felixsuhimitsu/cast-256/docs/10-devbook/DEVELOPMENT_BOOK.md

# DEVELOPMENT BOOK — Đã thử gì, sai ở đâu, vì sao chọn hướng này

**Artifact xuyên suốt** · Cập nhật: 2026-09-09

---

## 1. Tài liệu này khác ADR ở chỗ nào

- **ADR** ghi *quyết định*: chọn gì, vì sao, hệ quả. Bất biến sau khi Accepted.
- **Development Book** ghi *quá trình*: đã thử gì, cái gì không chạy, số đo thật, người
  sửa AI ở đâu. Ghi thêm liên tục, không xóa.

Một điều sai đã thử mà không được ghi lại sẽ bị thử lại. Đó là lý do phần §4 tồn tại.

---

## 2. Nhật ký theo work package

### WP-00 — Khung dự án · TT: ✅ Done (2026-09-09)

**Đã làm:**
- Xóa `rtl/` và `sim/` cũ (giữ nguyên trong lịch sử git trên nhánh `main`), dựng cây mới
  theo `MODULE_MAP.md` §1: `config/`, `ip/aes256/`, `ip/sha256/`, `protocol/`, `fabric/`, `io/`.
- `sim/lib/tb_util.vh`: macro `CHECK_EQ` / `CHECK_TRUE` / `CHECK_LE` / `TB_END` / `TB_TIMEOUT`.
  `TB_END` dùng `$fatal(1,...)` để iverilog trả **mã thoát khác 0** khi FAIL — điều kiện
  của REQ-V-01. Nếu chỉ `$finish` thì testbench FAIL vẫn trả 0 và CI sẽ báo xanh sai.
- `sim/lib/csi_checker.v`: module kiểm tự động INV-1..6 và quy tắc bắt tay H2, H5 của hợp
  đồng CSI. Instantiate song song với IP, đếm vi phạm ra cổng `viol_count`.
- `scripts/check_headers.sh` (REQ-N-02), `scripts/check_layering.sh` (MODULE_MAP §4).
- `Makefile`: target `lint / sim-* / synth-aes / synth-sha / synth / flash / test / bench`.

**Ba chỗ đưa bài học cũ thẳng vào công cụ, không để trong đầu:**
1. `synth` dùng `2>&1 | tee` cho nextpnr — công cụ ghi toàn bộ ra stderr, thiếu `2>&1`
   thì log luôn 0 byte (§4.1 mục 8).
2. `YOSYS_FLAGS` cố định `-nowidelut` kèm bình luận giải thích, để không ai bỏ đi lần nữa
   (§4.1 mục 3).
3. Target `test`/`bench` gọi `/usr/bin/python3` tường minh, không dùng `python3` (§4.1 mục 9).
   `PORT` mặc định `/dev/ttyUSB1`, có ghi chú `ttyUSB0` là JTAG (§4.1 mục 5).

**Tự kiểm gate (quan trọng):** `make lint` chạy sạch trên cây rỗng — nhưng "sạch" khi
không có gì để kiểm là vô nghĩa, đúng kiểu Done giả số 1 trong `DEFINITION_OF_DONE.md` §4.
Vì vậy đã dựng vi phạm cố ý để kiểm chính cái gate:

| Vi phạm dựng lên | Gate | Kết quả |
|---|---|---|
| File trong `ip/aes256/` không có header | `check_headers.sh` | FAIL, exit=1 ✅ |
| Module trong `ip/` instantiate module của `io/` | `check_layering.sh` | FAIL, exit=1 ✅ |
| (sau khi dọn) | cả hai | PASS, exit=0 ✅ |

Gate được chứng minh là bắt được vi phạm thật, không phải luôn xanh.

**Còn nợ (đã xử lý một phần ở WP-01):** `constraints/tangnano9k.cst` kế thừa có hai vấn
đề — 3 LED khai `LVCMOS18` trong khi `rst_n` cùng IO bank là `LVCMOS33` (làm `gowin_pack`
dừng, không sinh bitstream), và gán chân UART bị ngược. `constraints/uart_echo.cst` của
WP-01 đã dùng gán chân đúng và LVCMOS33 toàn bộ, đã kiểm chứng trên board. File
`tangnano9k.cst` sẽ được viết lại ở WP-07 dựa trên bản đã kiểm chứng này.

### WP-01 — Đường ống UART trần · TT: ✅ Done (2026-09-09) — **GATE CỨNG ĐÃ QUA**

**Đã làm:** `baud_gen.v`, `uart_rx.v`, `uart_tx.v` + bitstream thăm dò
`rtl/probe/uart_echo_top.v` (FIFO 16 byte). Tổng hợp 331 LUT4, F_max 140 MHz.

#### Lỗi 1 — testbench bắt được lỗi thật trong `uart_rx`

TC-301 (biểu quyết 3 điểm chống nhiễu) FAIL 6/8: nhiễu 1 chu kỳ trên các bit có
giá trị 0 vẫn lọt qua ở bit 3 và bit 5.

Nguyên nhân: `vote` được dùng ở **đúng chu kỳ** mà `samples[2]` đang được gán.
Vì gán là nonblocking, `vote` đọc giá trị **cũ** của `samples[2]` — vốn là `1`
từ lần reset. Nên với bit giá trị 0, phép biểu quyết thành `majority(s0, s1, 1)`:
chỉ cần một trong hai mẫu còn lại bị nhiễu là kết quả lật.

Sửa: thêm `SDEC = S2 + 1`, quyết định trễ một chu kỳ sau mẫu cuối. Dự phòng bắt
sườn start còn 234 − 126 = **108 chu kỳ**, vẫn dư xa so với 3.75 chu kỳ của
thiết kế cũ. TC-300..302 sau đó PASS 10/10.

Đây đúng loại lỗi mà chỉ testbench có kịch bản nhiễu mới bắt được — một bộ test
chỉ gửi byte sạch sẽ PASS hoàn toàn.

#### Lỗi 2 — GÁN CHÂN UART CỦA THIẾT KẾ TRƯỚC BỊ NGƯỢC

Nạp lần đầu với `rx=17, tx=18` (chép từ `constraints/tangnano9k.cst` của thiết
kế cũ): **0/512 byte vọng về**, và ca đối chứng có nghỉ 1 ms cũng 0/64.

Chính ca đối chứng là thứ chỉ đúng hướng: nếu là mất đồng bộ tích lũy thì ca có
nghỉ phải chạy được. Cả hai đều bằng 0 nghĩa là **không có đường về**, tức là
vấn đề vật lý chứ không phải logic.

Đảo chân rồi nạp lại:

| Gán chân | 512 byte liên tục | 1024 | 4096 |
|---|---|---|---|
| rx=17, tx=18 (như thiết kế cũ) | **0/512** | — | — |
| **rx=18, tx=17** | **512/512** | **1024/1024** | **4096/4096** |

Kết luận: trên Tang Nano 9K, **chân 18 là FPGA THU, chân 17 là FPGA PHÁT**.
`constraints/tangnano9k.cst` kế thừa từ thiết kế trước ghi ngược, và điều này
phải sửa trước khi dùng ở WP-07.

> Ghi chú về nhận định trước đó: trong phiên làm việc trước, giả thuyết "đảo chân
> UART" từng bị coi là đã bác bỏ. Số đo ở đây cho thấy kết luận đó sai. Bằng
> chứng là 4096/4096 với gán chân đảo so với 0/512 với gán chân cũ, trên cùng
> một board, cùng một bitstream logic.

#### Kết quả gate

| Bài | Kết quả |
|---|---|
| TC-600a: 512 byte liên tục, không nghỉ | **0 byte mất** ✅ |
| TC-600b: nội dung đúng từng byte | ✅ |
| Bổ sung: 1024 byte | 0 mất ✅ |
| Bổ sung: 4096 byte | 0 mất ✅ |
| Thông lượng đo được | 4096 B trong 355.6 ms ≈ 11.5 kB/s (đạt trần lý thuyết) |

REQ-I-05 **đạt**, chứng minh trên phần cứng thật (REQ-V-03). Log gốc:
`evidence/hw/20260909-2230-TC600-uartloop-4096.log`.

### WP-02 — Thăm dò diện tích · TT: ✅ Done (2026-09-09)

**Đổi cách làm so với WBS.** Kế hoạch ban đầu là đo "khung rỗng" của AES và SHA. Nhưng
yosys sẽ tối ưu mất logic rỗng, cho ra số vô nghĩa — đo xong vẫn không biết gì. Thay vào
đó đã viết và đo **hai khối thật sự tốn diện tích nhất**: S-Box composite field và hàm nén
SHA-256. Số đo vì thế là số thật, và code viết ra dùng luôn được cho WP-03/WP-04.

**S-Box: sinh hằng số bằng Python trước, viết Verilog sau.**
`scripts/gen_sbox_basis.py` tìm phép đẳng cấu GF(2^8)→GF(((2²)²)²) bằng cách quét
(PHI, LAM, nghiệm t), rồi **kiểm đủ 256/256 giá trị so với S-Box FIPS 197 ngay trong
Python**. Chỉ khi Python báo PASS mới chép hằng số sang Verilog. Kết quả:
`PHI=2, LAM=8, t=0x41`. Đây là biện pháp trực tiếp cho RSK-03 — nếu để Verilog tự "đúng
hay sai thì chạy testbench mới biết" thì lỗi lộ ra dưới dạng "vector AES fail" không manh mối.

**Tự kiểm TC-100 bằng lỗi cố ý.** Đổi một hằng số ma trận từ `8'h6C` thành `8'h6D`:

| Phép kiểm | Với S-Box hỏng |
|---|---|
| Đối chiếu 256 giá trị | **FAIL** — 128 giá trị sai, exit=1 ✅ |
| Kiểm song ánh | **vẫn PASS** ⚠️ |

Đúng như RSK-03 dự đoán: S-Box sai vẫn có thể là song ánh. Nếu chỉ kiểm song ánh hoặc chỉ
thử vài giá trị thì lỗi lọt qua. Đây là lý do REQ-F-04 ghi rõ "đối chiếu **toàn bộ** 256".

**Một tối ưu có đo, và nó thực sự có tác dụng.** `sha256_compress` đo lần đầu 1132 LUT4,
trong đó 844 là LUT3 — mux 3 chiều trên 256 bit trạng thái `a..h` (ba nhánh
`init`/`step`/`finalize`). Bỏ việc nạp lại `a..h` ở nhánh `finalize` (khối kế tiếp dùng
`init` với `h_in = h_out`) → còn 2 nguồn → **892 LUT4, giảm 240 (21%)**.

Khác biệt so với ba lần "tối ưu" thất bại ở §4.1: lần này **đo trước, thấy chỗ tốn, rồi
mới sửa** — không phải đoán rồi sửa.

**Kết luận gate:** cả hai IP dự phóng vượt ngân sách *riêng* ban đầu, nhưng tổng toàn
thiết kế chỉ ~5740/8640 (66%), còn xa trần REQ-R-01. Theo đúng thủ tục gate: dừng lại, mở
[`ADR-0007`](../09-decisions/ADR-0007-dieu-chinh-ngan-sach-dien-tich.md), nới REQ-R-03
(2200→2400) và REQ-R-04 (1800→2000), giữ nguyên ngân sách tổng. Kèm hai quyết định kiến
trúc: AES dùng 16 S-Box (không phải 20, khóa vòng tính sẵn), `sha256_k` giữ dạng logic.

### WP-03 — IP SHA-256 · TT: ✅ Done (2026-09-09)

**Đã làm:** `sha256_pad.v` (đệm FIPS 180-4) + `sha256_ip.v` (đỉnh IP theo hợp đồng CSI),
ghép với `sha256_k/sched/compress` đã viết ở WP-02. Testbench `tb_sha256_ip.v` **PASS 17/17**.
Diện tích **1661 LUT4 / 1146 DFF / 464 ALU** — dưới ngưỡng REQ-R-04 (2000), dùng 83% ngân sách.

#### Lỗi 1 — điều khiển có thanh ghi làm lệch pha K[t] với W[t]

Bản đầu dùng tín hiệu điều khiển được ghi vào thanh ghi (`cmp_step <= 1'b1`). Hệ quả:
`round` tăng ở chu kỳ trước khi vòng nén tương ứng thực sự chạy, nên `K[1]` bị ghép với
`W[0]`. Đã phát hiện khi phân tích dạng sóng bằng tay trước cả khi chạy testbench.

Sửa: chuyển toàn bộ tín hiệu điều khiển sang **tổ hợp** dẫn xuất trực tiếp từ `state`.
Khi đó trong mỗi chu kỳ `ST_COMPRESS`, các đại lượng `round`, `w_t`, `k_t` và `step` đều
thuộc cùng một vòng. Thêm một trạng thái `ST_CINIT` một chu kỳ để nạp trạng thái H.

#### Lỗi 2 — tớ tự bịa vector kiểm chứng

Bản testbench đầu tiên có sáu giá trị digest cho các độ dài 55/56/63/64/119 byte được
viết ra từ trí nhớ, không tra nguồn. Khi đối chiếu lại bằng `hashlib`:

| Độ dài | Giá trị đã viết | Đúng? |
|---|---|---|
| 55 byte | `9f4390f8…0f734318` | đúng |
| **56 byte** | `…ef797686_86b6b6f3` | **SAI** (đúng là `…ef797068_6ec6738a`) |
| 63, 64 byte | — | đúng |
| **119 byte** | `1c8bfa4a…5d4f0b56` | **SAI hoàn toàn** |

Nếu để nguyên, hai vector sai này sẽ làm testbench FAIL trên một IP **đúng**, và nhiều
khả năng phản ứng tiếp theo là đi sửa RTL cho khớp vector sai. Đây chính là điều REQ-V-02
cấm: **không dùng vector tự sinh làm nguồn sự thật**.

Đã thay toàn bộ bằng giá trị sinh từ `hashlib` (hiện thực tham chiếu của FIPS 180-4) và
ghi rõ nguồn trong testbench.

#### Lỗi 3 — vi phạm hợp đồng CSI ở nhánh lỗi

`csi_checker` bắt được 2 vi phạm khi `csi_mode` không hợp lệ: IP báo `csi_done` ngay
trong `ST_IDLE`, tức là `done` lên khi chưa từng `busy` (INV-1), và `busy` không bao giờ
lên sau `start` (INV-4).

Có hai cách sửa: nới hợp đồng, hoặc sửa IP. **Chọn sửa IP** — thêm trạng thái `ST_ERR`
một chu kỳ. Hợp đồng là ranh giới của đề tài; nới nó ra để code dễ hơn là làm hỏng đúng
thứ đang được chấm điểm.

#### Lỗi 4 — đo diện tích bằng grep cho số GẤP ĐÔI

Lần đo đầu báo **3322 LUT4**, tức là vượt ngưỡng 2000 rất xa và suýt nữa dẫn tới một
đợt "tối ưu" không cần thiết. Nguyên nhân: yosys in bảng thống kê **hai lần** (một cho
module, một cho `design hierarchy`), và lệnh `grep | awk` cộng cả hai. Số thật là **1661**.

Đã viết `scripts/area.py` chỉ lấy khối đầu tiên, và thay `grep|awk` trong Makefile bằng
script này. Một gate cho số sai còn tệ hơn không có gate.

#### Giới hạn thật, đã ghi vào SRS §10.4

Hợp đồng CSI đánh dấu byte cuối bằng `sin_last` **đi kèm một byte hợp lệ**, nên **thông
điệp độ dài 0 không biểu diễn được**. Đã bỏ độ dài 0 khỏi tiêu chí REQ-F-11 thay vì giả
vờ test nó. Không ảnh hưởng hệ thống (REQ-F-21 buộc `LEN ∈ [1,512]`), nhưng ai dùng lại
IP ở dự án khác cần biết.

### WP-04 — IP AES-256 · TT: ✅ Done (2026-09-09)

**Đã làm:** `aes256_round.v`, `aes256_keysched.v`, `aes256_cipher.v`, `aes256_ctr_ip.v`.
Testbench `tb_aes256_ip.v` **PASS 17/17**. Diện tích **2528 LUT4 / 1357 DFF**.

#### Rút kinh nghiệm từ WP-03: đối chiếu vector TRƯỚC khi viết testbench

Toàn bộ vector AES được chạy qua thư viện `cryptography` của Python và in ra để đối chiếu
**trước khi** gõ vào file Verilog. Không có vector nào viết từ trí nhớ. Đây là hệ quả trực
tiếp của việc 2/6 vector SHA ở WP-03 bị sai.

#### Lỗi 1 — độ trễ đọc bộ nhớ khóa vòng: đúng khóa mà vẫn sai kết quả

Bản đầu cho ra bản mã sai hoàn toàn. Dump khóa vòng ra so với FIPS 197 A.3: **cả 15 khóa
vòng đều đúng**. Dump từng vòng: vòng 1 dùng `rk[0]` thay vì `rk[1]`.

Nguyên nhân: đọc bộ nhớ có thanh ghi nên `rk_rd` ở chu kỳ N là `rk_mem[địa chỉ ở chu kỳ
N-1]`. Địa chỉ phải chạy trước **hai** nhịp so với chỗ nó được dùng, tôi chỉ cho chạy trước
một nhịp.

Bài học phương pháp: khi kết quả sai, dump **trạng thái trung gian từng bước** và so với mô
hình tham chiếu, đừng đoán. Chỉ mất hai lần chạy để khoanh vùng từ "sai hoàn toàn" xuống
"một dòng gán địa chỉ".

#### Lỗi 2 — 13/15 khóa vòng đúng, hai khóa đầu lệch một byte

Sau khi sửa lỗi 1, cipher đúng khi thử riêng nhưng IP vẫn sai. Dump `rk_mem` ở cấp IP:
`rk[0] = 0102...0f10` thay vì `000102...0e0f` — lệch đúng một byte. `rk[2..14]` đều đúng.

Nguyên nhân: `aes256_ctr_ip` nối cổng `key` của cipher bằng biểu thức tổ hợp
`{key_r[247:0], sin_data}` (để ghép byte thứ 32 ngay khi nó tới). Nhưng `keysched` đọc cổng
`key` ở trạng thái SEED, tức là **một chu kỳ sau**, khi biểu thức đó đã đổi giá trị. Khóa
vòng 2..14 vẫn đúng vì chúng sinh từ bản đã chốt bên trong (`w`).

Sửa: `ST_SEED` dùng `w` thay vì cổng `key`.

Kiểu lỗi này đặc biệt khó chịu vì **13/15 đúng** — nhìn bảng khóa vòng dễ tưởng là đúng hết.

#### Lỗi 3 — testbench sai, không phải IP sai

TC-107 fail: nạp khóa `K_FIPS` nhưng đối chiếu với keystream của `K_CTR`. Đã sửa test.
Ghi lại vì đây là lời nhắc: khi một test lẻ fail trong khi 16 test khác pass, khả năng cao
là test sai chứ không phải thiết kế sai.

#### Vượt ngân sách — và lần này TỐI ƯU THẬT trước khi nới

Bản 16 S-Box đo **2961 LUT4**, vượt REQ-R-03 (2400) 23%. Đây là lần thứ hai một ngân sách
IP bị vượt; lần đầu (ADR-0007) chỉ nới số, nên lần này bắt buộc phải thử tối ưu thật.

Đo trước để biết cắt ở đâu:

| Thành phần | LUT4 | Tỉ trọng |
|---|---|---|
| 16 × `aes256_sbox` | 1296 | **44%** |
| `aes256_keysched` | 619 | 21% |
| `aes256_round` | 382 | 13% |
| bộ nhớ khóa vòng + FSM | ~326 | 11% |
| `aes256_ctr_ip` | 338 | 11% |

| Thử gì | LUT4 | Nhận xét |
|---|---|---|
| Đưa bộ nhớ khóa vòng vào BSRAM | không khả thi | yosys không ánh xạ được mảng 15×128 sang BSRAM Gowin (cổng tối đa 32 bit) |
| **Giảm 16 → 8 S-Box, 2 chu kỳ/vòng** | 2961 → **2526** | biện pháp dự phòng #3 của ESTIMATION §4, hoạt động đúng như định lượng |
| Bỏ tầng thanh ghi cổng ra key schedule | 2526 → **2528** | **dự đoán của tôi SAI** |

Về mục cuối: tôi dự đoán tiết kiệm ~130 LUT4. Số đo cho thấy DFF giảm 133 nhưng **LUT4
không giảm** — các thanh ghi đó ánh xạ thẳng vào ô DFF, không tiêu LUT nào để mà bỏ đi.
Giữ thay đổi (133 DFF rẻ hơn thì vẫn tốt) nhưng lý do giữ là số đo, không phải lý do ban đầu.

Đây là lần thứ tư trong hai dự án một phép "tối ưu" theo suy đoán không cho kết quả như dự
đoán. Tỉ lệ hiện tại: 1 đúng (mux 3 chiều ở WP-02, có đo trước) trên 4 lần suy đoán.

Kết luận, ghi ở [`ADR-0008`](../09-decisions/ADR-0008-ngan-sach-aes-sau-toi-uu.md):
giữ 8 S-Box, nới REQ-R-03 2400→2600 và REQ-P-05 20→32 chu kỳ. **Ngân sách TỔNG
(REQ-R-01/02) không đổi và chưa hề bị đụng tới** — dự phóng 5880/8640 = 68%.

#### Chỗ phủ chưa đầy đủ, đã ghi vào RTM §4b

REQ-F-05 (key schedule) **không có test trực tiếp** đối chiếu W[0..59]: `aes256_keysched`
không có cổng quan sát ở mức IP, và thêm cổng đó sẽ vi phạm §7 hợp đồng CSI. Đã đối chiếu
15/15 khóa vòng bằng testbench gỡ lỗi tạm thời, và nếu key schedule sai thì TC-101/TC-104
không thể PASS. Ghi rõ là phủ gián tiếp thay vì đánh dấu ✅.

### WP-05 — Fabric CSI · TT: ✅ Done (2026-09-09)

**Đã làm:** `ip_arbiter.v` (7 LUT4, 3 DFF), `stream_mux.v` (279 LUT4, tổ hợp thuần),
`sim/lib/csi_stub_ip.v` (IP giả lập), `tb_fabric.v` **PASS 17/17**.

**Dùng IP giả lập, không dùng IP thật.** Nếu cắm AES/SHA thật vào testbench fabric thì lỗi
ở fabric và lỗi ở IP sẽ trộn lẫn, và khi test fail sẽ không biết đổ cho bên nào. IP giả lập
đơn giản tới mức chắc chắn đúng, nên mọi lỗi còn lại đều thuộc về fabric. Một module giả lập
tham số hóa đóng được cả hai vai: kiểu AES (có dòng ra, không kết quả) và kiểu SHA (không
dòng ra, có kết quả).

**TC-402 là phép thử thật của hợp đồng CSI.** Nó cho hai IP có hành vi *khác hẳn nhau* chạy
qua cùng một `stream_mux` mà không sửa một dòng nào. Nếu `stream_mux` có bất kỳ giả định nào
kiểu "IP0 là AES" thì phần này fail. Đây là điều biến đề tài từ "hai khối mật mã" thành
"hai IP tích hợp được".

**Loại trừ tương hỗ được cưỡng chế ở HAI chỗ**, không phải một:
1. `ip_arbiter` chỉ cấp one-hot và giữ quyền tới khi bên yêu cầu nhả **và** IP hết bận.
2. `stream_mux` **chặn** `start`/`valid` tới mọi IP không được cấp quyền. Không chỉ tin
   bên điều phối cư xử đúng.

**`viol_concurrent` là chốt cảnh báo phần cứng, không phải chỉ mô phỏng.** Nếu hai IP cùng
báo bận thì cờ này bật và giữ; nó sẽ được nối ra LED lỗi ở WP-07. Nghĩa là vi phạm REQ-F-25
nhìn thấy được trên board thật, chứ không chỉ thấy trong testbench.

**Hai lỗi tìm được — đều ở testbench, không phải RTL:**
1. `use_ip` đặt lại `rxlen = 0` ở đầu mỗi lượt, nhưng phép kiểm lại giả định giá trị được
   giữ từ lượt trước.
2. Kiểm `m_result` **sau khi** đã nhả quyền. Lúc đó `grant = 0` nên mux trả về 0 — đúng
   hành vi mong muốn. Phải chốt kết quả tại đúng chu kỳ `m_done`.

Ghi lại vì cả hai đều là kiểu "test sai chứ không phải thiết kế sai", giống TC-107 ở WP-04.
Khi một vài phép kiểm lẻ fail giữa một loạt phép kiểm pass, nghi ngờ test trước.

### WP-06 — Lớp giao thức · TT: ✅ Done (2026-09-10)

**Đã làm:** `frame_rx.v`, `frame_buffer.v`, `digest_check.v`, `session_fsm.v`, `frame_tx.v`,
`led_status.v`, `config/keys.vh`, `top_secure_link.v`. Testbench `tb_top.v` **PASS 22/22**.
Toàn bộ 6 testbench của dự án đều PASS.

**Testbench lái qua đúng hai chân UART**, không thò tay vào tín hiệu bên trong, nên nó kiểm
được cả đường đi thật của dữ liệu.

**TC-500 là phép kiểm DƯƠNG, và nó suýt không có.** Bản testbench đầu tiên chỉ gồm các phép
kiểm "không có phản hồi" — digest sai, LEN sai, khung cắt, bit lật. Toàn bộ file đó sẽ PASS
hoàn hảo trên một thiết kế **chết hoàn toàn**. Đúng kiểu Done giả số 1 trong
`DEFINITION_OF_DONE.md` §4, và tôi tự viết ra nó.

Đã sửa bằng cách sinh giá trị kỳ vọng từ hiện thực tham chiếu Python với đúng khóa trong
`config/keys.vh`:

| Đại lượng | Giá trị |
|---|---|
| payload (16 byte) | `3c21066b48ad92f7d4391e036045aa8f` |
| DIG_IN = SHA-256(LEN‖IV‖payload) | `8a5b63d9…fd3000d0` — gửi lên |
| CT = AES-256-CTR(payload) | `8b9e3c36bc941b2a43c9e4948b8b85c5` — mong đợi |
| DIG_OUT = SHA-256(LEN‖IV‖CT) | `13c6f553…ea97b444` — mong đợi |

Nhờ vậy TC-500 kiểm trọn vẹn: mở khung → SHA → so digest → AES → SHA → đóng khung → phát.

#### Lỗi 1 — bắt tay chỉ kiểm `ready`, không kiểm `valid`

`if (m_sin_ready)` thay vì `if (m_sin_valid && m_sin_ready)`. Vì `m_sin_valid` là thanh ghi
nên ở chu kỳ đầu của mỗi trạng thái nạp nó vẫn bằng 0, và bộ đếm byte nhảy lên trong khi
byte chưa hề được gửi.

Triệu chứng rất đánh lừa: bước nạp khóa AES lúc khởi động không bao giờ kết thúc → `engine_busy`
kẹt ở 1 vĩnh viễn → byte đến bị chặn bởi `!engine_busy` → **toàn hệ thống câm lặng**. Nhìn từ
ngoài giống hệt "khung nào cũng bị loại", tức là giống hệt hành vi đúng khi digest sai.

Nếu testbench chỉ có các phép kiểm âm thì lỗi này sẽ **không bao giờ bị phát hiện**.

#### Lỗi 2 — điểm lấy mẫu UART cố định ±8 chu kỳ

`tb_top` dùng baud cao cho mô phỏng nhanh (DIV = 16). Với DIV nhỏ, ba điểm lấy mẫu 109/117/125
và điểm quyết định 126 nằm ngoài một bit (chỉ dài 16 chu kỳ) → FSM kẹt vĩnh viễn ở `ST_START`.

Sửa: `SPREAD` tỉ lệ theo DIV. Với DIV ≥ 64 giá trị vẫn là 8, nên **kết quả đã kiểm chứng
trên phần cứng ở WP-01 không bị thay đổi** — đã chạy lại `tb_uart` ở 115200 để xác nhận.

Đây là lỗi thật của RTL chứ không phải giới hạn của testbench: một module nhận tham số
`CLK_HZ`/`BAUD` mà chỉ chạy đúng ở một giá trị thì tham số đó là giả.

#### Lỗi 3 — độ trễ đọc bộ nhớ, lần thứ BA trong dự án

Địa chỉ đọc bộ đệm là thanh ghi, cộng với bộ nhớ đọc trễ một chu kỳ, thành hai chu kỳ — nên
trạng thái chờ một chu kỳ là không đủ và mỗi byte dùng dữ liệu của byte **trước đó**. SHA
tính ra digest sai, khung bị loại.

Hai lần trước cùng kiểu lỗi này ở bộ nhớ khóa vòng AES (WP-04). Cách chữa gốc, đã áp dụng cho
cả `session_fsm` và `frame_tx`: **để địa chỉ đọc là tổ hợp**, khi đó một trạng thái chờ là đủ
và đúng. Ghi vào §4.2 như một mẫu lỗi lặp lại, không phải ba sự cố rời rạc.

#### Lỗi 4 — watchdog 2²⁴ chu kỳ khiến REQ-F-24 không kiểm được

Khung bị cắt làm `frame_rx` khóa suốt 0,62 s thời gian mô phỏng — dài tới mức mọi testbench
thực tế đều bỏ qua, và REQ-F-24 sẽ không bao giờ *thực sự* được kiểm. Một requirement không
kiểm được thì coi như không có.

Sửa: tham số hóa `WDOG_BITS` (24 cho phần cứng, 12 trong mô phỏng). TC-506 giờ chạy đủ **hai
pha của REQ-V-04**: pha A khung cắt → im lặng, pha B khung hợp lệ sau đó → chạy đúng.

#### Ba lỗi ở testbench, không phải RTL

1. Đếm sai kích thước khung: 2+2+16+16+32 = **68**, tôi ghi 52. Thiết kế đúng ngay từ đầu —
   tất cả các phép kiểm nội dung (preamble, LEN, IV, bản mã, digest) đều đã PASS.
2. `send_frame` tự đặt lại bộ đếm byte nhận, làm TC-508 chỉ đếm khung thứ hai.
3. Kiểm "không phát thừa" bằng cách đọc ô nhớ chưa khởi tạo, thay vì đo lại sau một khoảng lặng.

### WP-07 — Tích hợp phần cứng · TT: ✅ Done (2026-09-10)

**Kết quả:** bitstream nạp được, **hệ thống chạy đúng trên board thật**. Bản mã AES-256-CTR
và digest SHA-256 nhận về khớp chính xác hiện thực tham chiếu Python, ở **cả 19 độ dài
payload** từ 1 tới 512 byte.

| Chỉ số | Đo được | Ngưỡng | |
|---|---|---|---|
| LUT4 | 6664 / 8640 (77%) | ≤ 7776 (REQ-R-01) | ✅ |
| DFF | 3568 / 6480 (55%) | ≤ 5184 (REQ-R-02) | ✅ |
| BSRAM | 5 / 26 (19%) | — | |
| ALU | 884 / 6480 (13%) | — | |
| IOB | 7 / 276 | — | |
| F_max | **46,85 MHz** | ≥ 27,0 MHz (REQ-P-01) | ✅ |

#### Lỗi 1 — P&R THẤT BẠI dù tài nguyên mới dùng 80%

`nextpnr`: *"Unable to find legal placement for all cells, design is probably at utilisation
limit"* — trong khi báo cáo cùng lúc nói LUT4 80%, DFF 60%.

Nguyên nhân: bộ nhớ khóa vòng AES là mảng 15 × **128 bit**. Cổng BSRAM của Gowin rộng tối đa
32 bit nên mảng đó không vào BSRAM được, yosys rơi về RAM phân tán và sinh **32 khối
RAM16SDP4**. RAM phân tán chỉ đặt được ở một số ô nhất định, và với 80% LUT đã chiếm chỗ thì
bộ đặt chỗ không tìm nổi cách sắp xếp hợp lệ.

Sửa: tách thành **bốn** bộ nhớ 16 × 32 bit song song, thêm thuộc tính `ram_style = "block"`.
Kết quả: 32 RAM16SDP4 → **0**, BSRAM 1 → 5 (còn thừa 21 khối), và P&R chạy qua.

Bài học: *"còn 20% tài nguyên"* không có nghĩa là *"đặt chỗ được"*. Loại tài nguyên và ràng
buộc vị trí quan trọng ngang số lượng.

#### Lỗi 2 — cắt bit ở đúng giá trị biên: LEN = 512

Khung 128 byte chạy hoàn hảo; khung **512 byte luôn bị loại**.

Nguyên nhân: `feed_total = {6'd0, len[AW-1:0]} + 18` với `AW = 9`. LEN tối đa 512 = `10'h200`,
tức bit thứ 9 — đúng bit bị `len[8:0]` cắt mất. Với LEN = 512 thì `len[8:0] = 0` và
`feed_total = 18` thay vì 530, nên SHA chỉ băm phần đầu khung và digest không bao giờ khớp.

Chỉ sai ở **đúng một giá trị** trong dải hợp lệ. Test một độ dài duy nhất sẽ không bao giờ
thấy. Đã thêm `--mode sweep` quét 19 độ dài gồm mọi giá trị biên lũy thừa hai ±1.

#### Ghi chú về báo cáo timing của nextpnr

nextpnr in `"PASS at 12.00 MHz"` cho mọi miền xung nhịp, dễ tưởng ràng buộc SDC không được
nạp. Kiểm lại: log có dòng `constraining clock net 'clk_27m' to 27.00 MHz`, tức SDC **có**
được áp dụng; câu "PASS at 12.00 MHz" là cách nextpnr-himbaechel đặt tên miền theo cell và
in ngưỡng mặc định. Con số có ý nghĩa là **F_max = 46,85 MHz**, vượt 27 MHz 1,7 lần.

### WP-08 — Đo hiệu năng · TT: ✅ Done (2026-09-10)

`--mode bench`, 100 khung × 128 byte payload, trên board thật:

| Chỉ số | Đo được | Ngưỡng | |
|---|---|---|---|
| Tỉ lệ mất khung | **0,00%** (0/100) | 0% (REQ-P-02) | ✅ |
| Độ trễ min / avg / max | 32,34 / **32,42** / 32,55 ms | ≤ 40 ms (REQ-P-03) | ✅ |
| Độ lệch chuẩn độ trễ | 0,03 ms | — | |
| Thông lượng | **10 778 B/s** (86,2 kbps) | ≥ 8000 B/s (REQ-P-04) | ✅ |

Độ lệch chuẩn 0,03 ms trên 100 khung cho thấy đường xử lý là **tất định**: không có bộ đệm
nào tràn, không có đường nào phụ thuộc dữ liệu. Đây là hệ quả trực tiếp của kiến trúc lặp
một miền xung nhịp.

Thông lượng 10 778 B/s so với trần lý thuyết của UART 115200 (11 520 B/s) là **93,6%** —
phần thiếu là 20 byte header và 32 byte digest mỗi khung, không phải do engine chậm. Engine
AES chạy ở 13,5 MB/s, tức nhanh hơn đường truyền hơn 1000 lần (ADR-0008).

Log gốc: `evidence/hw/20260910-0956-TC-602-bench.log`.

### WP-09 — Test đối kháng · TT: ✅ Done (2026-09-10)

Cả ba kịch bản đều chạy **đủ hai pha** theo REQ-V-04:

| Test | Pha A (kích thích tiêu cực) | Pha B (bằng chứng còn sống) | |
|---|---|---|---|
| TC-603 tamper | lật 1 bit payload → 0 byte trả về | khung hợp lệ ngay sau → đúng | ✅ |
| TC-604 timeout | khung cắt sau 10 byte → 0 byte | sau watchdog 0,62 s → đúng | ✅ |
| TC-605 garbage | 32 byte rác → 0 byte | rác + khung hợp lệ → nhận đúng | ✅ |

**Vì sao pha B là bắt buộc.** Ở thiết kế trước, `--mode tamper` và `--mode timeout` chỉ kiểm
"FPGA trả về 0 byte" và **cả hai vẫn báo PASS trong khi bitstream hỏng hoàn toàn**. Một test
chỉ có pha A không phân biệt được "từ chối đúng" với "đã chết" — hai trạng thái đó nhìn từ
ngoài giống hệt nhau.

Điều này không phải giả định: chính ở WP-06 lỗi bắt tay `valid`/`ready` đã làm toàn hệ thống
câm lặng, và triệu chứng bên ngoài **y hệt** hành vi đúng khi digest sai.

Log gốc: `evidence/hw/20260910-0956-TC-{tamper,timeout,garbage}.log`.

### WP-10 — RTM & báo cáo · TT: ✅ Done (2026-09-10)

**Đã làm:** đóng RTM (36/39 REQ có bằng chứng), cập nhật SCOPE §2 với kết quả đo, sinh
`docs/hinh1_kien_truc.png`, dựng `docs/BaoCao_SanPham_HuTieu_VMBMATTT_2026.docx` + `.pdf`
từ mẫu của ban tổ chức — **5 trang A4** đúng giới hạn.

Mọi con số trong báo cáo đều truy được về một file log trong `evidence/`.

#### Bốn lỗi khi dựng báo cáo

1. **Chỉ số đoạn văn lệch.** Ghi đè nội dung vào ba tiêu đề mục (5. THỰC NGHIỆM,
   5.4 Đánh giá bảo mật, 6. MỨC ĐỘ HOÀN THIỆN) vì nhầm rằng đoạn kế tiếp một tiêu đề là
   ô trống. Sửa bằng cách đối chiếu lại toàn bộ bảng chỉ số của mẫu và dùng `after()` /
   `before()` thay vì ghi đè.
2. **Xóa bảng làm lệch chỉ số bảng.** `d.tables[5]` không còn tồn tại sau khi xóa
   `d.tables[0]`. Phải lấy tham chiếu phần tử XML **trước** khi xóa.
3. **Ký tự `‖` (U+2016) không có trong font**, hiển thị thành `l` — công thức
   `SHA-256(LEN‖IV‖PT)` thành `SHA-256(LENlIVlPT)`, đọc ra vô nghĩa. Thay bằng `||`.
   Đây là lỗi lặp lại từ lần làm báo cáo trước.
4. **Hình bị cắt mất phần bên phải** khi đặt trong ô bảng của mẫu — đúng chỗ có hai khối
   IP, tức là phần quan trọng nhất của hình. Ô bảng có bề rộng cố định hẹp hơn vùng chữ.
   Sửa: bỏ bảng, đặt ảnh trong đoạn thường.

Cả bốn đều là lỗi *hiển thị* chứ không phải nội dung, nhưng ba trong bốn chỉ phát hiện
được bằng cách **kết xuất PDF rồi nhìn từng trang**. Đọc lại mã sinh báo cáo không đủ.

#### Vẽ lại Hình 1 sau phản hồi của người dùng (2026-09-15)

Bản đầu bị chê "mũi tên chồng chéo lên nhau, nhìn rối". Đúng: bản đó đặt các khối theo
toạ độ tự do rồi nối bằng mũi tên **chéo**, nên chỉ cần vài đường là cắt nhau, và hai
mũi tên hai chiều giữa fabric và IP chạy đè lên nhau.

Sửa bằng cách đổi *nguyên tắc bố cục* chứ không phải kéo lại từng mũi tên:
- Mỗi tầng là một **băng ngang** chiếm trọn chiều rộng.
- Có **cột lề trái** riêng cho nhãn tầng, nên nhãn không bao giờ đè lên khối.
- Mọi mũi tên chỉ đi **thẳng đứng hoặc thẳng ngang** — không có đường chéo thì về mặt
  hình học không thể có hai mũi tên cắt nhau ngoài điểm giao vuông góc có chủ đích.

Script vẽ lưu ở `scripts/gen_figure.py` để tái lập được.

#### Còn lại — thuộc phần người phụ trách, không phải AI

| Việc | Trạng thái |
|---|---|
| Video demo, ảnh chụp | **Bỏ** — người phụ trách quyết định không quay/chụp vì không bắt buộc. Hàng "VIDEO DEMO / QR" trong báo cáo để trống có chủ đích |
| Quan sát ba đèn LED (REQ-F-30..32) | ✅ Người phụ trách xác nhận trên board 2026-09-15 |
| Điền **Human correction log** (§5) | Theo định nghĩa phải do người làm — xem ghi chú bên dưới |

### WP-11 — Phủ hết test · TT: ✅ Done (2026-09-15)

Người phụ trách xác nhận phần cứng chạy tốt và yêu cầu **phủ hết test**. Rà lại RTM cho
thấy 5 test case trong kế hoạch **chưa hề tồn tại**, và 4 requirement đang được đánh dấu
đạt bằng *đọc code* hoặc *suy luận* chứ không bằng test tự động.

| REQ | Trước đây | Đã làm gì | Kết quả |
|---|---|---|---|
| REQ-F-05 | Phủ **gián tiếp**: "nếu key schedule sai thì TC-101/104 không PASS" | `tb_keysched.v` — kiểm **module con**, 60/60 word, **hai** khóa khác nhau | 5/5 PASS |
| REQ-F-23 | Đánh dấu đạt bằng **đọc RTL** | TC-507 — đo chu kỳ loại khung khi byte digest sai ở vị trí đầu vs cuối | 208 = 208 |
| REQ-P-05 | Con số suy **bằng tay** | TC-103 — bộ đếm tự động | **32**, không phải 30 |
| REQ-P-06 | Con số suy **bằng tay** | TC-205 — bộ đếm tự động | **66**, không phải 65 |
| REQ-F-12 | Chỉ 2–3 khối | TC-204 — 1000 byte = 16 khối | PASS |
| REQ-F-30..32 | "Chờ quan sát bằng mắt" | `tb_led_status.v` 15 phép kiểm **+** xác nhận trên board | PASS |

#### Điều đáng nói nhất: hai con số tôi ghi sai suốt dự án

REQ-F-05 hoá ra **không cần** thay đổi RTL nào. Lý do tôi viện ra trước đây — "thêm cổng
quan sát sẽ vi phạm §7 hợp đồng CSI" — chỉ đúng với **đỉnh IP**. Module con hoàn toàn kiểm
riêng được, và testbench tự cấp 4 khối S-Box cho cổng "mượn". Tức là chỗ phủ thiếu đó tồn
tại vì tôi chấp nhận một lý do nghe hợp lý mà không kiểm lại, chứ không phải vì khó.

Nghiêm trọng hơn: khi thay phép suy luận bằng bộ đếm tự động, **hai con số lệch**:

| | Tôi đã ghi | Đo được |
|---|---|---|
| Chu kỳ mã hóa một khối AES | 30 | **32** |
| Chu kỳ nén một khối SHA | 65 | **66** |

Nguyên nhân: tôi đếm các trạng thái trong FSM bằng mắt và bỏ sót hai chu kỳ bao quanh
(nhận lệnh, chốt kết quả). Hai con số sai này đã lan vào **7 chỗ**: bình luận đầu hai file
RTL, hình kiến trúc, bảng kết quả trong báo cáo nộp, ADR-0008, RTM và Development Book.

Ngưỡng REQ-P-05 là 32 nên vẫn đạt — nhưng **vừa khít** chứ không dư như tôi tưởng. Nếu sau
này ai đó thêm một chu kỳ vào FSM, gate sẽ đỏ, và đó chính là tác dụng mong muốn của việc
có bộ đếm thật thay vì một con số chép tay.

Đây là ví dụ trực tiếp cho quy tắc D10 trong `DEFINITION_OF_DONE.md`: **số đo thật, không
phải số suy ra**. Tôi viết ra quy tắc đó ở WP-00 rồi tự vi phạm nó ở WP-03 và WP-04.

#### Một lỗi nữa ở testbench

`tb_led_status.v` bản đầu đổi `drop_pulse` **đúng lúc sườn lên** — đua giữa testbench và
DUT, thứ tự thực thi không xác định. Kết quả: báo LED2 không sáng trong khi RTL hoàn toàn
đúng. Sửa bằng cách đưa mọi kích thích sang **sườn xuống**.

---

## 3. Số đo thật

Chỉ ghi số **đọc từ log công cụ**, không ghi số ước lượng. Mỗi dòng phải trỏ được về một
file trong `evidence/`.

### 3.1 Tài nguyên theo module (tổng hợp riêng lẻ)

| Ngày | Module | LUT4 | ALU | DFF | Ngân sách | Đạt? | Ghi chú |
|---|---|---|---|---|---|---|---|
| 2026-09-09 | `aes256_sbox` | **81** | 0 | 0 | 70 | ⚠️ +16% | ×16 = 1296 trong AES |
| 2026-09-09 | `sha256_sched` | **242** | 32 | 512 | 420 | ✅ −42% | cửa sổ trượt hiệu quả hơn dự kiến |
| 2026-09-09 | `sha256_k` | **286** | 0 | 0 | 180 | ⚠️ +59% | ROM 64×32 dạng logic |
| 2026-09-09 | `sha256_compress` | 1132 | 352 | 512 | 780 | ❌ +45% | trước khi sửa mux 3 chiều |
| 2026-09-09 | `sha256_compress` | **892** | 352 | 512 | 780 | ⚠️ +14% | sau khi sửa, −240 LUT4 |
| 2026-09-09 | **`sha256_ip` (cả IP)** | **1661** | 464 | 1146 | 2000 (REQ-R-04) | ✅ 83% | `make synth-sha`, log ở `evidence/synth/` |
| 2026-09-09 | `aes256_round` | 382 | 0 | 0 | — | — | tổ hợp thuần |
| 2026-09-09 | `aes256_keysched` | 619 | — | 496 | — | — | mượn 4 S-Box của cipher |
| 2026-09-09 | `aes256_ctr_ip` (16 S-Box) | 2961 | 160 | 1425 | 2400 | ❌ 123% | bản đầu |
| 2026-09-09 | `aes256_ctr_ip` (8 S-Box) | 2526 | 153 | 1490 | 2400 | ❌ 105% | sau biện pháp dự phòng #3 |
| 2026-09-09 | **`aes256_ctr_ip` (cuối)** | **2528** | 153 | 1357 | 2600 (ADR-0008) | ✅ 97% | `make synth-aes` |
| 2026-09-09 | `uart_echo_top` (cả `io/`) | 331 | 64 | 222 | — | — | đã nạp board, F_max 140 MHz |
| 2026-09-09 | `ip_arbiter` | 7 | 0 | 3 | 90 | ✅ | rẻ hơn ước lượng 13 lần |
| 2026-09-09 | `stream_mux` | 279 | 0 | 0 | 150 | ⚠️ +86% | tổ hợp thuần; giá của việc tích hợp IP |

Cách đo: `yosys -p "read_verilog <file>; synth_gowin -no-rw-check -nowidelut -top <mod>"`.
Cột LUT4 là tổng LUT1+LUT2+LUT3+LUT4 — trên Gowin mọi loại đều chiếm một slot LUT4.
Ngân sách đã điều chỉnh theo ADR-0007 sau đợt đo này.

### 3.2 Tài nguyên toàn thiết kế

| Ngày | Phiên bản | LUT4 | % | DFF | % | BSRAM | F_max | Kết quả |
|---|---|---|---|---|---|---|---|---|
| 2026-09-09 | `uart_echo_top` (thăm dò WP-01) | 331 | 3% | 222 | 3% | 0 | 140 MHz | nạp OK |
| 2026-09-10 | `top_secure_link`, khóa vòng ở RAM phân tán | 6940 | 80% | 3888 | 60% | 1 | — | **P&R THẤT BẠI** |
| 2026-09-10 | `top_secure_link`, khóa vòng ở BSRAM | 6688 | 77% | 3568 | 55% | 5 | 48,68 MHz | P&R OK |
| 2026-09-10 | **bản cuối (sửa LEN=512)** | **6664** | **77%** | **3568** | **55%** | **5** | **46,85 MHz** | ✅ chạy trên board |

Ngưỡng: REQ-R-01 LUT4 ≤ 7776 (90%), REQ-R-02 DFF ≤ 5184 (80%), REQ-P-01 F_max ≥ 27,0 MHz.
Log gốc trong `evidence/synth/`.

### 3.3 Hiệu năng phần cứng

| Ngày | Chế độ | Số byte/khung | Mất | Thông lượng | Ghi chú | Log |
|---|---|---|---|---|---|---|
| 2026-09-09 | uartloop (TC-600) | 512 byte | **0** | — | gate WP-01 | `evidence/hw/` |
| 2026-09-09 | uartloop | 1024 byte | **0** | 11.5 kB/s | — | `evidence/hw/` |
| 2026-09-09 | uartloop | 4096 byte | **0** | 11.5 kB/s | 355.6 ms | `evidence/hw/20260909-2230-TC600-uartloop-4096.log` |
| 2026-09-10 | echo (TC-601) | 128 byte | 0 | — | 32,4 ms khứ hồi | `evidence/hw/20260910-0957-TC-601-echo.log` |
| 2026-09-10 | sweep (TC-601s) | 19 độ dài, 1→512 | **0** | — | 10,3→99,2 ms | `evidence/hw/20260910-0957-TC-601s-sweep.log` |
| 2026-09-10 | **bench (TC-602)** | **100 khung × 128 B** | **0 (0,00%)** | **10 778 B/s** | **avg 32,42 ms, σ 0,03** | `evidence/hw/20260910-0956-TC-602-bench.log` |
| 2026-09-10 | tamper/timeout/garbage | mỗi bài 2 pha | — | — | đủ liveness | `evidence/hw/20260910-0956-TC-*.log` |

---

## 4. Những thứ đã thử và KHÔNG chạy

Phần này quý hơn phần "đã chạy". Ghi lại để không ai (kể cả AI trong phiên sau) thử lại.

### 4.1 Từ thiết kế trước — đã kiểm chứng, không lặp lại

| # | Đã thử | Kết quả | Vì sao sai |
|---|---|---|---|
| 1 | Thêm HMAC-SHA-256 vào bitstream | 7359/8640 LUT4 (85%), P&R **FAIL** | Hai instance SHA không vừa. Xem ADR-0004 |
| 2 | "Tối ưu" HMAC bằng thanh ghi dịch | 7724 LUT4 (89%) — **tệ hơn** | Mỗi bit cần mux 3 chiều nạp/dịch/giữ, đắt hơn thanh ghi thường |
| 3 | Bỏ cờ `-nowidelut` để dùng LUT rộng | 9248 LUT4 (107%) — **tệ hơn nhiều** | Trên Gowin, MUX2_LUT5..8 được dựng **từ chính LUT4**. Không hề tiết kiệm, còn thêm chi phí định tuyến |
| 4 | Đổ lỗi cáp sạc khi board không enumerate | Sai — đổi cáp thứ hai vẫn không lên | Nguyên nhân thật ở đầu cắm phía chip. Bài học: chẩn đoán một-nguyên-nhân quá sớm |
| 5 | Đọc `/dev/ttyUSB0` để lấy dữ liệu UART | Ra dữ liệu rác, tưởng lỗi giao thức | `ttyUSB0` là kênh **JTAG** của FT2232. Kênh UART là `ttyUSB1` |
| 6 | Giả thuyết đảo chân UART 17/18 | Sai — bitstream thăm dò chứng minh chân đúng | Mất thời gian vì đoán thay vì đo |
| 7 | Chạy lệnh nạp bitstream ở chế độ nền | Tiến trình treo giữ thiết bị FTDI, phải rút cắm lại | Lệnh chạm phần cứng phải chạy tiền cảnh |
| 8 | `\| tee nextpnr.log` để lưu log P&R | File luôn 0 byte | nextpnr ghi ra **stderr**. Phải `2>&1 \| tee` |
| 9 | Dùng `python3` sau khi `source oss-cad-suite/environment` | `pyserial is required` | Toolchain che `python3` hệ thống bằng bản riêng. Gọi `/usr/bin/python3` |
| 10 | Đọc bản báo cáo telemetry **đầu tiên** sau khi gửi | Số liệu vô nghĩa | Khung mất 10.2 ms, báo cáo mỗi 300 ms → mẫu rơi giữa khung. Phải đọc bản **cuối** |

### 4.2 Trong dự án này

| # | Đã thử | Kết quả | Vì sao |
|---|---|---|---|
| 1 | Đo "khung rỗng" của IP để thăm dò diện tích (theo WBS ban đầu) | Bỏ, không làm | yosys tối ưu mất logic rỗng → số vô nghĩa. Đổi sang đo hai khối tốn nhất và viết thật |
| 2 | Gán `a..h` ở cả ba nhánh init/step/finalize trong `sha256_compress` | 1132 LUT4, trong đó 844 LUT3 | Mỗi bit trong 256 bit cần mux 3 chiều. Bỏ nhánh `finalize` → 892 LUT4 |
| 3 | Dùng `vote` ngay tại chu kỳ lấy mẫu thứ ba trong `uart_rx` | TC-301 FAIL 6/8 | Gán nonblocking: `samples[2]` chưa cập nhật, vote đọc giá trị cũ. Phải quyết định ở `S2+1` |
| 6 | Tín hiệu điều khiển SHA đặt trong thanh ghi | K[t] lệch pha với W[t] | `round` tăng trước khi vòng nén chạy. Chuyển sang điều khiển tổ hợp dẫn xuất từ `state` |
| 7 | Viết vector digest từ trí nhớ thay vì tra nguồn | 2/6 vector SAI | Vector sai làm testbench FAIL trên IP đúng → dễ dẫn tới sửa RTL cho khớp vector sai. Luôn sinh vector từ hiện thực tham chiếu (REQ-V-02) |
| 8 | Đo diện tích bằng `grep 'LUT' \| awk sum` | 3322 thay vì 1661 — **gấp đôi** | yosys in bảng thống kê hai lần. Dùng `scripts/area.py` |
| 9 | Cho địa chỉ đọc bộ nhớ khóa vòng chạy trước MỘT nhịp | Vòng 1 dùng `rk[0]`, bản mã sai hoàn toàn | Đọc có thanh ghi nên phải chạy trước HAI nhịp |
| 10 | Nối cổng `key` của keysched bằng biểu thức tổ hợp `{key_r, sin_data}` | `rk[0]`, `rk[1]` lệch một byte; `rk[2..14]` đúng | Cổng đó đổi giá trị ở chu kỳ sau. Phải dùng bản đã chốt bên trong (`w`) |
| 11 | Đưa mảng khóa vòng 15×128 vào BSRAM Gowin | Không ánh xạ được | Cổng BSRAM Gowin rộng tối đa 32 bit; yosys rơi về logic phân tán |
| 12 | Bỏ tầng thanh ghi cổng ra key schedule để cứu LUT | DFF −133 nhưng **LUT4 +2** | Thanh ghi ánh xạ thẳng vào ô DFF, không tiêu LUT nào để bỏ đi |
| 13 | Điều kiện bắt tay chỉ kiểm `ready` | Nạp khóa AES không bao giờ xong, toàn hệ câm lặng | `valid` là thanh ghi nên chu kỳ đầu vẫn bằng 0. Phải kiểm `valid && ready` |
| 14 | Điểm lấy mẫu UART cố định ±8 chu kỳ | FSM kẹt khi DIV nhỏ | Khoảng cách mẫu phải tỉ lệ theo DIV, nếu không tham số `BAUD` chỉ là trang trí |
| 15 | **Địa chỉ đọc bộ nhớ để trong thanh ghi** (lần 3) | Dữ liệu trễ một byte | Bộ nhớ đã trễ 1 chu kỳ; địa chỉ qua thanh ghi thành 2. **Để địa chỉ là tổ hợp** |
| 16 | Watchdog 2²⁴ chu kỳ cố định | REQ-F-24 không testbench nào kiểm nổi | Tham số hóa để mô phỏng dùng giá trị nhỏ |
| 17 | Viết testbench toàn phép kiểm ÂM ("không có phản hồi") | Sẽ PASS trên thiết kế chết | Phải có ít nhất một phép kiểm DƯƠNG. Chính tôi viết ra rồi tự bắt được |
| 18 | Mảng khóa vòng 15×128 bit, tin rằng yosys sẽ đưa vào BSRAM | 32 RAM16SDP4, **P&R thất bại ở 80% LUT** | Cổng BSRAM Gowin rộng tối đa 32 bit. Tách thành 4 mảng ×32 + `ram_style="block"` |
| 19 | `len[AW-1:0]` với AW=9 trong khi LEN tối đa là 512 | Khung 512 byte luôn bị loại, 128 byte hoàn hảo | Cắt đúng bit thứ 9. Lỗi biên chỉ lộ ở một giá trị duy nhất — phải quét dải |
| 20 | Tin rằng "còn 20% tài nguyên" nghĩa là đặt chỗ được | P&R vẫn thất bại | Loại tài nguyên và ràng buộc vị trí quan trọng ngang số lượng |
| 21 | Đếm chu kỳ FSM **bằng mắt** rồi ghi vào tài liệu | Sai cả hai: AES 30→**32**, SHA 65→**66** | Bỏ sót hai chu kỳ bao quanh. Số sai lan ra 7 chỗ. Phải có **bộ đếm tự động** |
| 22 | Chấp nhận lý do "thêm cổng quan sát sẽ vi phạm hợp đồng CSI" mà không kiểm lại | REQ-F-05 thiếu test suốt dự án | Hợp đồng chỉ ràng buộc **đỉnh IP**; module con kiểm riêng được, không cần đổi RTL |
| 23 | Đổi kích thích testbench **đúng lúc sườn lên** | Báo LED2 không sáng trong khi RTL đúng | Đua giữa testbench và DUT. Kích thích phải đổi ở **sườn xuống** |
| 4 | Chép gán chân UART từ `constraints/tangnano9k.cst` cũ (rx=17, tx=18) | 0/512 byte vọng về | Ngược chân. Đúng là **rx=18, tx=17** — đã đo trên board |
| 5 | Tin rằng giả thuyết "đảo chân UART" đã bị bác bỏ ở phiên trước | Sai | Kết luận cũ không có số đo đi kèm. Bài học: một giả thuyết chỉ được coi là bác bỏ khi có phép đo, không phải khi có lập luận |

---

## 5. Human correction log — bằng chứng người can thiệp

Theo `../05-risk/RISK_DELEGATION.md` §4: một artifact chỉ được đánh ✅ khi người phụ trách
đã chỉ ra ít nhất một chỗ AI sai hoặc thiếu, và sửa lại.

| Ngày | Artifact | AI sai/thiếu chỗ nào | Người sửa thành | Ai |
|---|---|---|---|---|
| — | — | — | — | — |

> **Bảng này vẫn rỗng, và đó là điều cần nói thẳng.**
>
> Toàn bộ 11 artifact và toàn bộ RTL trong repo này do AI soạn. Chúng đã qua rất nhiều vòng
> tự sửa — 20 mục trong §4.2 là những lần chính AI phát hiện mình sai — nhưng **tự sửa không
> phải là review**. Theo `RISK_DELEGATION.md` §4 mà chính dự án này đặt ra, một artifact chỉ
> hoàn thành khi **người phụ trách** giải thích được nó, chỉ ra ít nhất một chỗ AI sai hoặc
> thiếu, sửa lại, và ghi vào bảng này.
>
> Vì vậy chỉ số "Review evidence" trong `RTM.md` §6 là **0%**, và nó nên ở nguyên đó cho tới
> khi có người thật ngồi xuống đọc. Điền con số khác vào đó sẽ đúng nghĩa là rubber-stamp —
> thứ mà toàn bộ quy trình này được dựng lên để chống.

**Năm chỗ đáng soi nhất, xếp theo mức độ đáng ngờ:**

1. **`aes256_sbox.v`** — hằng số ma trận đổi cơ sở do script sinh. Đã kiểm 256/256 giá trị,
   nhưng nếu `gen_sbox_basis.py` sai thì cả script lẫn Verilog cùng sai một kiểu và test
   vẫn PASS. Cách kiểm độc lập: so vài giá trị S-Box với bảng in trong FIPS 197 Hình 7.
2. **`session_fsm.v`** — module dài nhất, 26 trạng thái, đã có 4 lỗi trong quá trình viết.
   Đáng đọc lại từng nhánh chuyển trạng thái.
3. **Giới hạn bảo mật ở SRS §10** — kiểm xem phần công bố đã đủ trung thực chưa, có chỗ nào
   nói quá về mức bảo vệ không.
4. **Các con số trong báo cáo** — mỗi con số phải truy được về một file trong `evidence/`.
   Đối chiếu ngẫu nhiên vài con số.
5. **`ESTIMATION.md`** — ước lượng PERT dựa trên cảm tính, chưa bao giờ được đối chiếu với
   thời gian thực tế đã bỏ ra.

Gợi ý những chỗ đáng soi kỹ nhất, vì đó là chỗ AI dễ sai nhất:

1. **Ngân sách LUT4 trong `MODULE_MAP.md` §2** — các con số này là *ước lượng của AI*,
   chưa đo. Tổng 7690 chỉ dư 11%. Nếu ước lượng lệch 15% thì kế hoạch vỡ. WP-02 tồn tại
   để kiểm chính chỗ này.
2. **Ngân sách timing trong `ARCHITECTURE.md` §6** — các số ns là ước đoán, chưa chạy
   phân tích tĩnh nào.
3. **Ước lượng PERT trong `ESTIMATION.md`** — dựa trên cảm tính, không có dữ liệu lịch sử
   của chính đội này.
4. **Danh mục test case** — kiểm xem có test nào "kiểm sai thứ" giống bug ở §4.1 mục 1
   của TEST_PLAN không.
5. **Số chu kỳ REQ-P-05/06** (≤20 và ≤70) — kiểm lại bằng tay xem có khả thi với kiến
   trúc đã chọn không, hay là con số đặt cho đẹp.

---

## 6. Thư mục bằng chứng

`evidence/` chứa log gốc, không chỉnh sửa:

```
evidence/
├── synth/       báo cáo nextpnr theo ngày, đặt tên <ngày>-<commit ngắn>.log
├── sim/         đầu ra testbench
└── hw/          log chạy trên board, có timestamp
```

Quy tắc: **mọi con số xuất hiện trong báo cáo nộp phải truy được về một file ở đây.**
