felixsuhimitsu/cast-256/(commit log)

2026-09-04 fix(synthesis): force synchronous BSRAM inference on quarantine and framing buffers to resolve flip-flop explosion
    Resource summary (GW1NR-LV9QN88PC6/I5):
    - DFF: 3,499 / 6,480 (54%) <= 3,500 target MET
    - BSRAM: 5 / 26 (19%) [1x SPX9 + 4x DPX9B]
    - Fmax: 59.21 MHz (target >= 27.0 MHz) PASS
    - WNS: +66.4 ns >= 0 PASS
    - Bitstream: build/synth/crypto_transceiver.fs
    Key changes:
    - packet_deframer: dec_writing -> wire = (|dec_sub_cnt), shift register
    streaming for PT buffer writes eliminates 128-to-8 dynamic mux
    - packet_framer: enc_writing -> wire = (|enc_sub_cnt), removing 3 dead
    procedural assignments
    - All sims pass: sim-top (loopback/tamper/timeout), sim-aes, sim-sha
    [test_transceiver.py, uart_rx.v, uart_tx.v]
2026-09-04 feat(delivery): add hardware verification suite, demo protocol, and final KMA technical report
    - scripts/flash_openfpgaloader.sh: SRAM/flash mode selection, post-flash LED guide
    - scripts/test_transceiver.py: CLI with --mode echo/tamper/timeout/benchmark,
    NIST KAT defaults, throughput measurement, color output
    - docs/DEMO_PROTOCOL.md: Live jury demonstration runbook (4 scenarios)
    - docs/KMA_Technical_Report.md: Full engineering report with architecture,
    security analysis, NIST compliance proof, and silicon verification tables
2026-09-09 docs: khoi tao artifact chain buoc 1-4 cho de tai AES-256/SHA-256 IP
    - docs/README.md: ban do tai lieu, quy tac cap nhat nguoc, quy uoc ID
    - 00-scope/SCOPE.md: muc tieu G1-G5, in/out of scope, gia dinh phai kiem chung
    - 01-spec/SRS.md: REQ-F/I/P/R/V/N co tieu chi chap nhan do duoc
    - 02-module-map/MODULE_MAP.md: cay module, ngan sach LUT4, rang buoc phu thuoc
    - 03-architecture/ARCHITECTURE.md + IP_INTERFACE_CONTRACT.md: hop dong CSI v1.0
    Chuyen tai lieu thiet ke cu sang docs/_legacy/.
2026-09-09 docs: hoan thien artifact chain buoc 5-11 va decision log
    - 04-plan/WBS.md: 11 work package chia lat doc, gate cung o WP-01 va WP-02
    - 04-plan/ESTIMATION.md: PERT 54 phien, ngan sach LUT4, 5 phuong an du phong dinh luong
    - 05-risk/RISK_DELEGATION.md: 10 rui ro co diem, bang uy quyen Xanh/Vang/Do cho AI
    - 06-gates/: Definition of Ready + Definition of Done, 4 kieu 'Done gia' da gap that
    - 07-test/TEST_PLAN.md: 3 muc L1/L2/L3, 40 test case, quy tac chong PASS gia (2 pha)
    - 08-traceability/RTM.md: ma tran REQ -> WP -> module -> test -> bang chung
    - 09-decisions/: ADR-0001..0006
    - 10-devbook/: nhat ky, so do that, 10 thu da thu va khong chay, human correction log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
2026-09-09 feat(WP-00): dung khung du an - Makefile, cay RTL moi, lint gate co tu kiem
    - Xoa rtl/ va sim/ cu (con nguyen trong lich su git tren main), dung cay moi
    theo MODULE_MAP: config/ ip/aes256/ ip/sha256/ protocol/ fabric/ io/
    - sim/lib/tb_util.vh: TB_END dung $fatal(1) de tra ma thoat khac 0 khi FAIL (REQ-V-01)
    - sim/lib/csi_checker.v: kiem tu dong INV-1..6 va bat tay H2/H5 cua hop dong CSI
    - scripts/check_headers.sh (REQ-N-02), scripts/check_layering.sh (MODULE_MAP §4)
    - Makefile: dua 3 bai hoc cu thang vao cong cu (2>&1 cho nextpnr, -nowidelut co dinh,
    /usr/bin/python3 tuong minh, PORT mac dinh ttyUSB1)
    Da tu kiem gate bang vi pham co y: ca hai script deu FAIL dung cho va exit=1,
    roi PAS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
    [uart_rx.v, uart_tx.v]
2026-09-09 feat(WP-01): UART qua gate cung — 4096 byte lien tuc, 0 mat tren board that
    RTL: io/baud_gen.v, io/uart_rx.v, io/uart_tx.v, probe/uart_echo_top.v
    Test: sim/unit/tb_uart.v (TC-300..302), scripts/hw_test.py (TC-600)
    Constraints: constraints/uart_echo.cst
    HAI LOI TIM DUOC:
    1. uart_rx dung ket qua bieu quyet ngay tai chu ky lay mau thu ba, nen doc
    gia tri CU cua samples[2] (gan nonblocking). TC-301 FAIL 6/8: nhieu tren
    bit gia tri 0 lot qua. Sua bang SDEC = S2+1, quyet dinh tre mot chu ky.
    Du phong bat suon start con 108 chu ky (thiet ke cu chi co 3.75).
    2. Gan chan UART cua thiet ke truoc BI NGUOC. Nap that len board:
    rx=17, tx=18 (nhu cu) -> 0/512 byte vong ve
    rx=18,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
    [baud_gen.v, hw_test.py, tb_uart.v, uart_echo_top.v, uart_rx.v, uart_tx.v]
2026-09-09 feat(WP-03): IP SHA-256 theo hop dong CSI — 17/17 vector PASS, 1661 LUT4
    RTL: ip/sha256/sha256_pad.v (dem FIPS 180-4), ip/sha256/sha256_ip.v (dinh IP CSI)
    Test: sim/unit/tb_sha256_ip.v — TC-202/203/206/207/208/209
    Cong cu: scripts/area.py (doc so tai nguyen dung tu log yosys)
    Ket qua gate:
    make sim-sha PASS 17/17 (abc, 1/55/56/63/64/119/120 byte 'a')
    make synth-sha 1661 LUT4 <= 2000 (REQ-R-04), 83% ngan sach
    REQ-P-06 65 chu ky nen mot khoi <= 70
    BON LOI TIM DUOC:
    1. Tin hieu dieu khien dat trong thanh ghi lam `round` tang truoc khi vong nen
    chay -> K[1] ghep voi W[0]. Chuyen sang dieu khien to hop dan xuat tu state.
    2. Toi tu bia 6 gia tri digest tu tri nho thay vi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
2026-09-09 feat(WP-04): IP AES-256-CTR theo hop dong CSI — 17/17 vector PASS, 2528 LUT4
    RTL: ip/aes256/{aes256_round,aes256_keysched,aes256_cipher,aes256_ctr_ip}.v
    Test: sim/unit/tb_aes256_ip.v — TC-101/104/105/106/107/108/109
    ADR: docs/09-decisions/ADR-0008-ngan-sach-aes-sau-toi-uu.md
    make sim-aes PASS 17/17 (FIPS 197 C.3, SP 800-38A F.5.5 ca 4 khoi, counter wrap)
    make synth-aes 2528 LUT4 <= 2600 (REQ-R-03 sau ADR-0008), 97% ngan sach
    REQ-P-05 30 chu ky/khoi <= 32
    Rut kinh nghiem WP-03: TOAN BO vector duoc doi chieu voi thu vien tham chieu
    (python cryptography) truoc khi go vao Verilog. Khong vector nao viet tu tri nho.
    BA LOI TIM DUOC:
    1. Dia chi doc bo nho khoa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
2026-09-09 feat(WP-05): fabric CSI — loai tru tuong ho cuong che o hai tang, 17/17 PASS
    RTL: fabric/ip_arbiter.v (7 LUT4), fabric/stream_mux.v (279 LUT4)
    Test: sim/lib/csi_stub_ip.v (IP gia lap), sim/integ/tb_fabric.v (TC-400..403)
    Dung IP GIA LAP chu khong cam AES/SHA that vao: neu dung IP that thi loi o
    fabric va loi o IP tron lan, test fail khong biet do cho ben nao.
    TC-402 la phep thu that cua hop dong CSI: hai IP co hanh vi khac han nhau
    (mot co dong ra khong ket qua, mot nguoc lai) chay qua CUNG MOT stream_mux
    ma khong sua mot dong nao. Neu mux co gia dinh "IP0 la AES" thi phan nay fail.
    Loai tru tuong ho (REQ-F-25) duoc cuong che o HAI cho:
    1. ip_arbiter chi cap one-hot, giu quyen toi kh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
    [ip_arbiter.v, stream_mux.v, tb_fabric.v]
2026-09-10 feat(WP-06): lop giao thuc — toan he chay dung tu dau den cuoi, 22/22 PASS
    RTL: protocol/{frame_rx,frame_buffer,digest_check,session_fsm,frame_tx}.v
    io/led_status.v, config/keys.vh, top_secure_link.v
    Test: sim/integ/tb_top.v (TC-500..508), lai qua DUNG hai chan UART
    Toan bo 6 testbench cua du an deu PASS. Dien tich 5789 LUT4 / 3696 DFF /
    808 ALU / 1 BSRAM (chua P&R), duoi tran REQ-R-01 (7776).
    TC-500 la phep kiem DUONG va no SUYT KHONG CO. Ban testbench dau tien cua toi
    chi gom cac phep kiem "khong co phan hoi" — toan bo file do se PASS hoan hao
    tren mot thiet ke CHET HOAN TOAN. Dung kieu Done gia so 1 trong
    DEFINITION_OF_DONE §4, va chinh toi viet ra no. Da sua bang cach sinh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
2026-09-10 feat(WP-07/08/09): he thong chay tren board that — 0% mat khung, F_max 46,85 MHz
    constraints/tangnano9k.cst viet lai theo gan chan DA KIEM CHUNG o WP-01
    (chan 18 = FPGA thu, chan 17 = FPGA phat — nguoc voi ban ke thua)
    scripts/hw_test.py: day du 6 che do, moi che do "tu choi" chay DU HAI PHA
    KET QUA TREN PHAN CUNG
    LUT4 6664/8640 (77%) nguong REQ-R-01 7776 OK
    DFF 3568/6480 (55%) nguong REQ-R-02 5184 OK
    BSRAM 5/26 (19%)
    F_max 46,85 MHz nguong REQ-P-01 27 MHz OK
    TC-601s 19/19 do dai payload (1..512) deu dung ban ma va digest
    TC-602 100 khung: 0,00% mat, do tre avg 32,42 ms (sigma 0,03), 10 778 B/s
    TC-603/604/605 tamper/timeout/garbage: du hai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
2026-09-10 docs(WP-10): dong RTM 36/39 va dung bao cao nop — 5 trang A4
    docs/BaoCao_SanPham_HuTieu_VMBMATTT_2026.docx + .pdf (5 trang A4)
    docs/hinh1_kien_truc.png (so do bon tang)
    scripts/gen_report.py (tai lap duoc bao cao)
    Moi con so trong bao cao truy duoc ve mot file log trong docs/10-devbook/evidence/.
    BON LOI KHI DUNG BAO CAO:
    1. Chi so doan van lech -> ghi de noi dung len BA tieu de muc. Sua bang cach doi
    chieu lai bang chi so cua mau va dung after()/before() thay vi ghi de.
    2. Xoa bang lam lech chi so bang: d.tables[5] khong con sau khi xoa d.tables[0].
    Phai lay tham chieu XML TRUOC khi xoa.
    3. Ky tu U+2016 khong co trong f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
2026-09-15 docs: ve lai Hinh 1 va de trong phan video/hinh anh
    HINH 1 — doi NGUYEN TAC bo cuc chu khong keo lai tung mui ten.
    Ban dau dat khoi theo toa do tu do roi noi bang mui ten CHEO, nen chi can vai
    duong la cat nhau, va hai mui ten hai chieu giua fabric va IP chay de len nhau.
    Ban moi:
    - moi tang la mot BANG NGANG chiem tron chieu rong
    - co COT LE TRAI rieng cho nhan tang, nhan khong de len khoi
    - moi mui ten chi di THANG DUNG hoac THANG NGANG, nen ve mat hinh hoc khong
    the co hai mui ten cat nhau
    Giam be rong figure de khi ep ve 16,8 cm trong bao cao thi chu to va ro hon.
    Script ve luu o scripts/gen_figure.py de tai lap duoc.
    VIDEO va HINH ANH — theo quyet dinh cua nguoi phu trach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
2026-09-15 test: phu het RTM 39/39 — them 5 test case, phat hien 2 con so ghi sai
    Nguoi phu trach xac nhan phan cung chay tot va yeu cau phu het test. Ra lai RTM
    cho thay 5 test case trong ke hoach CHUA HE TON TAI va 4 requirement dang duoc
    danh dau dat bang DOC CODE hoac SUY LUAN chu khong bang test tu dong.
    TEST MOI:
    sim/unit/tb_keysched.v TC-102 60/60 word FIPS 197 A.3, HAI khoa khac nhau
    sim/unit/tb_led_status.v TC-606 15 phep kiem ba den chi thi
    tb_aes256_ip.v TC-103 bo dem chu ky ma hoa mot khoi
    tb_sha256_ip.v TC-205 bo dem chu ky nen mot khoi
    tb_sha256_ip.v TC-204 1000 byte = 16 khoi (noi trang thai H)
    tb_top.v TC-507 dig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
